JohnFrei/Pantorouter/photos/back-b.jpg

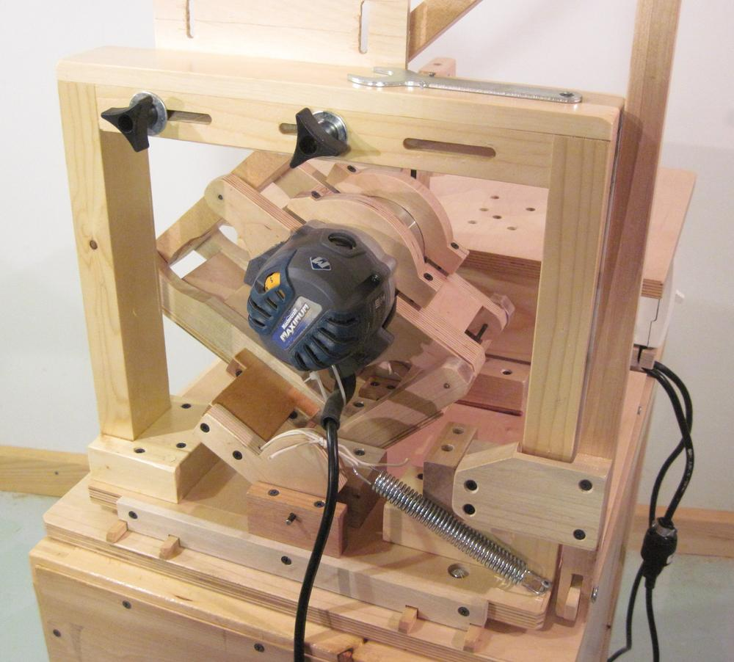
photos/back-b.jpg
