JohnFrei/Pantorouter/photos/front_left-b.jpg

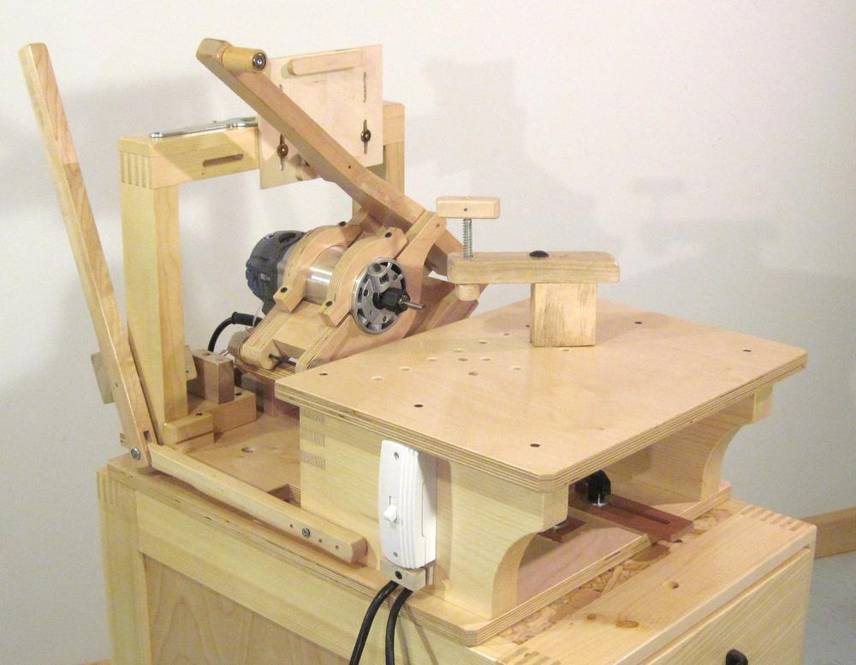
photos/front_left-b.jpg
