JohnFrei/Pantorouter/photos/front_profile-b.jpg

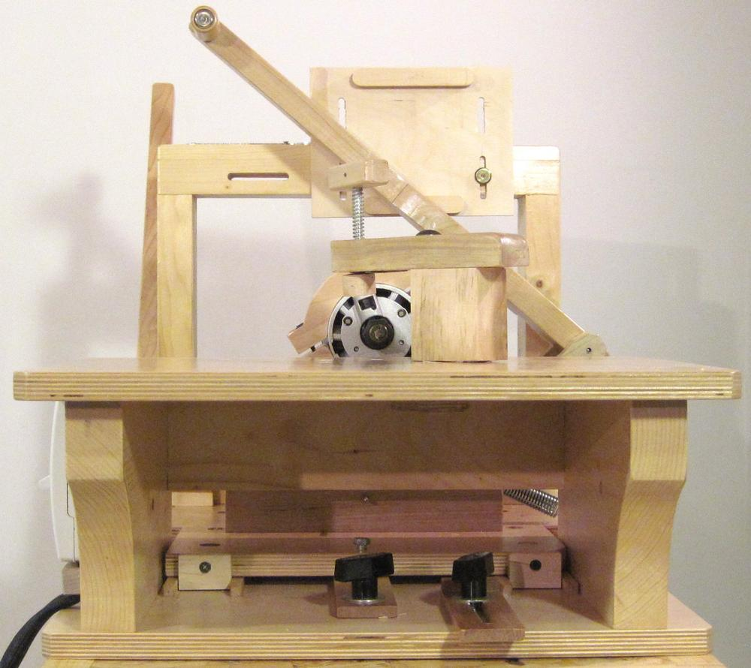
photos/front_profile-b.jpg
