JohnFrei/Pantorouter/photos/left_low-b.jpg

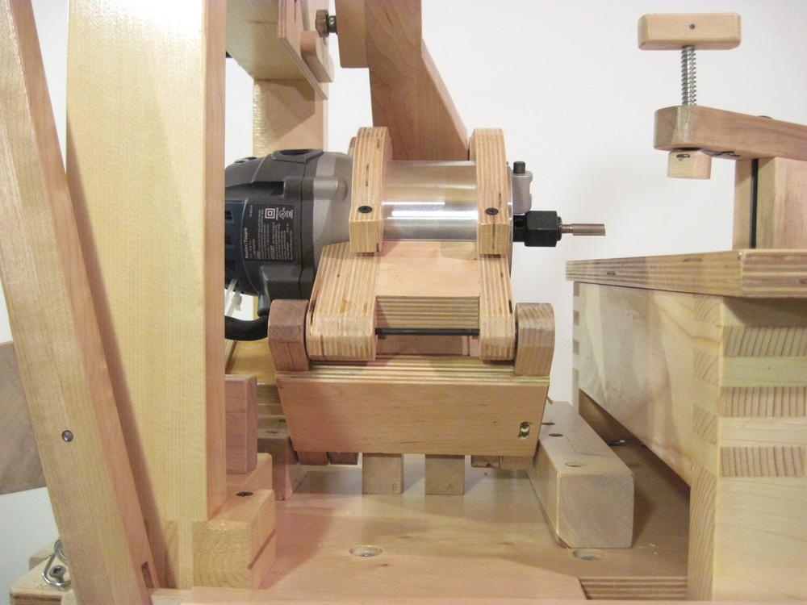
photos/left_low-b.jpg
