JohnFrei/Pantorouter/photos/left_max_height-b.jpg

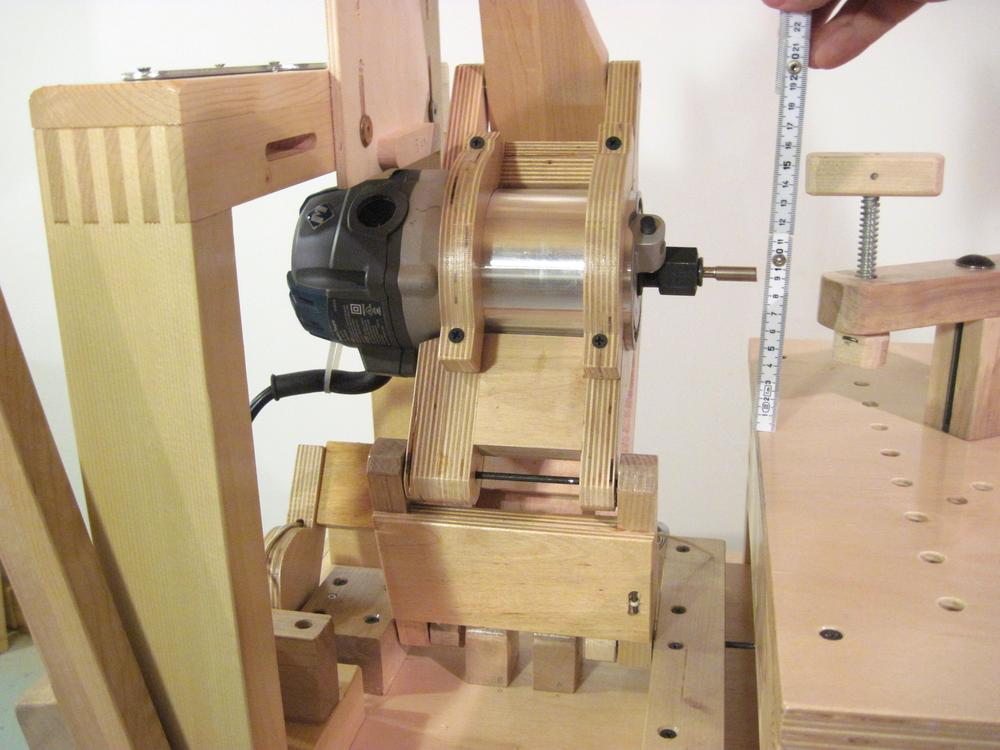
photos/left_max_height-b.jpg
