JohnFrei/Pantorouter/photos/left_side-b.jpg

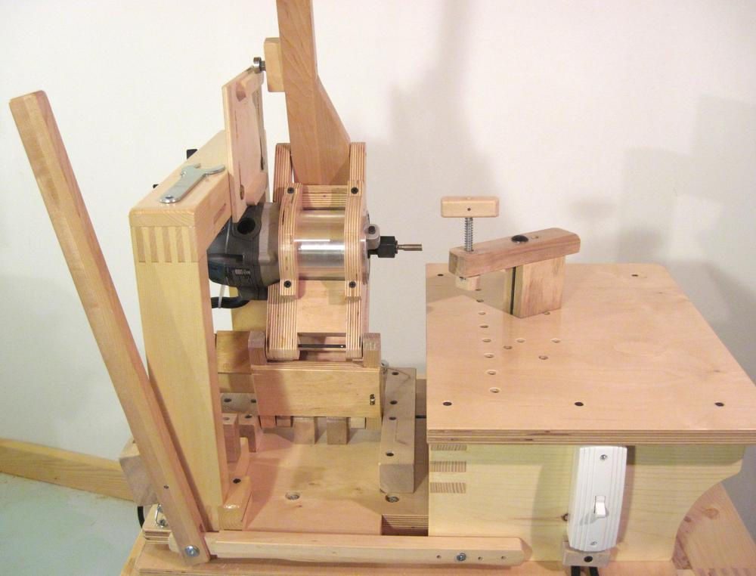
photos/left_side-b.jpg
