JohnFrei/Pantorouter/photos/right_side-b.jpg

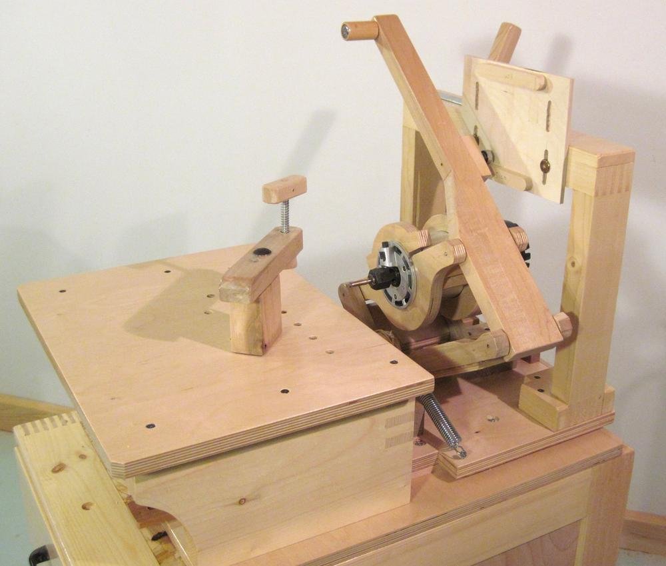
photos/right_side-b.jpg
