JohnFrei/Pantorouter/plans/11mm_ply.png

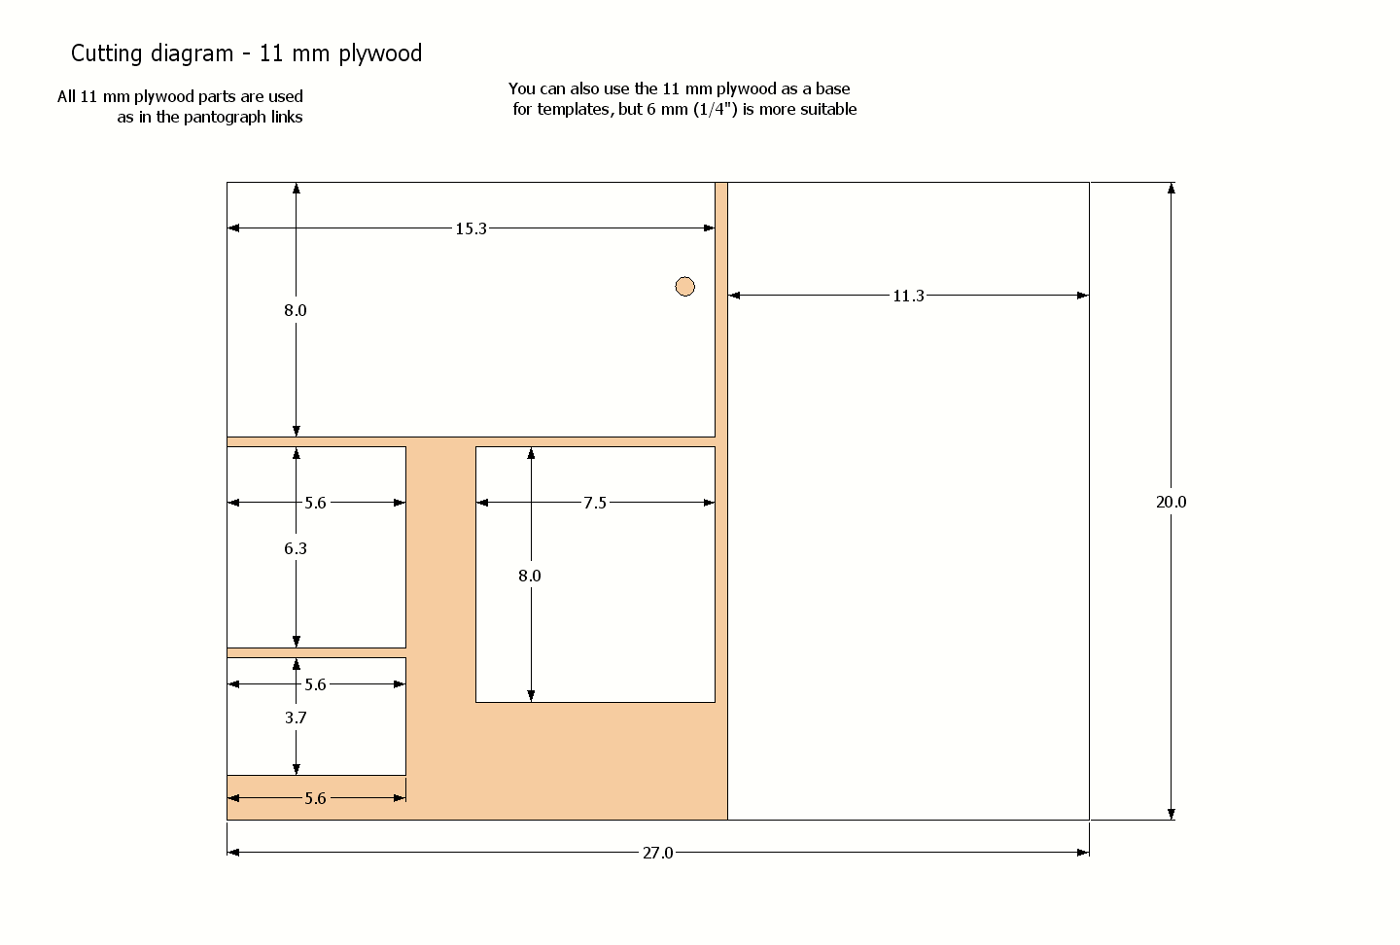
plans/11mm_ply.png
