JohnFrei/Pantorouter/plans/19mm_ply.png

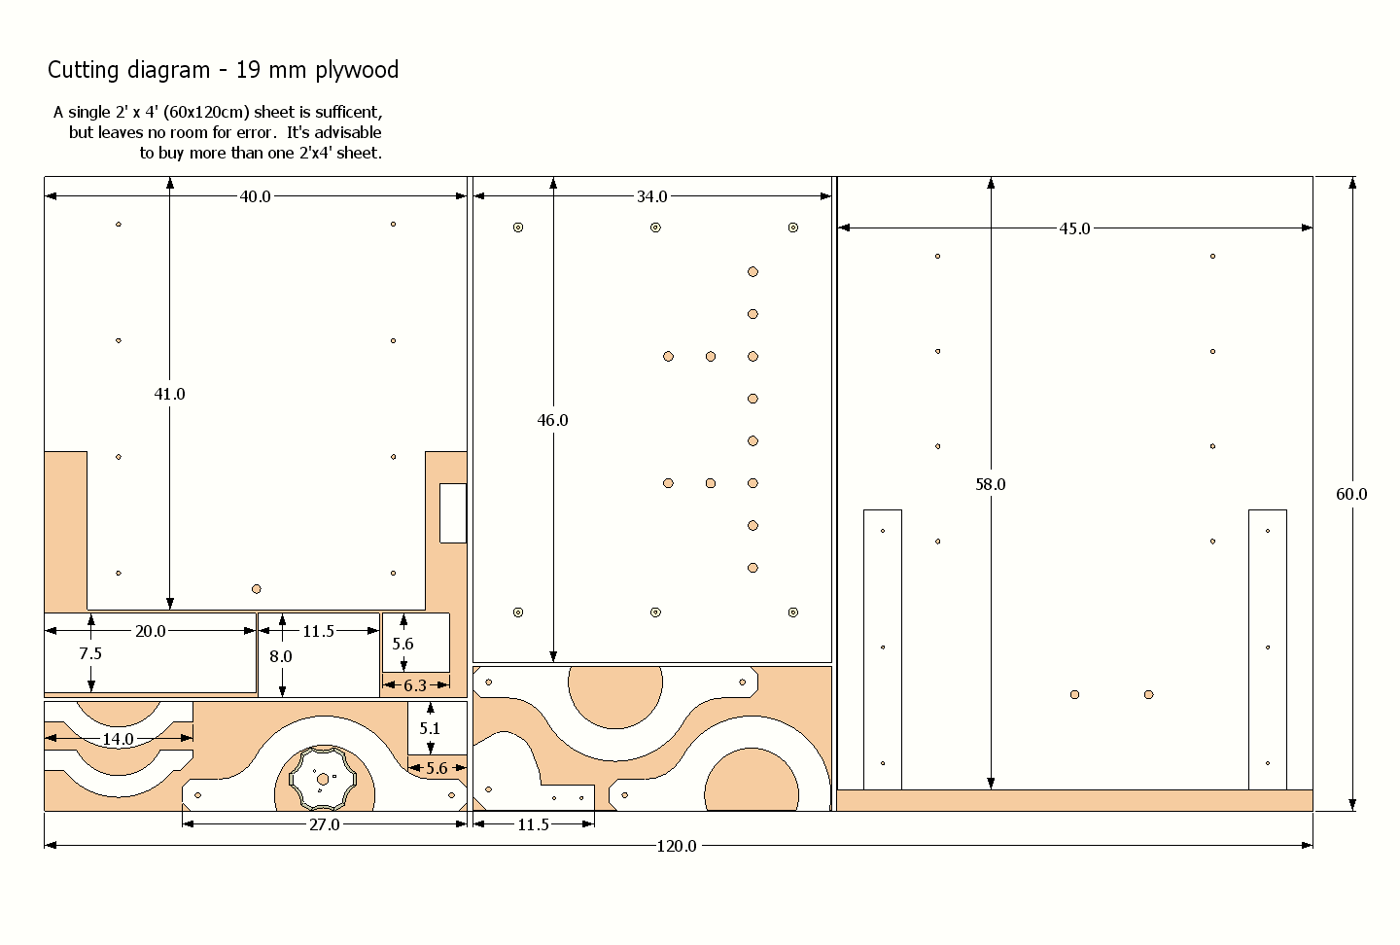
plans/19mm_ply.png
