JohnFrei/Pantorouter/plans/fence.png

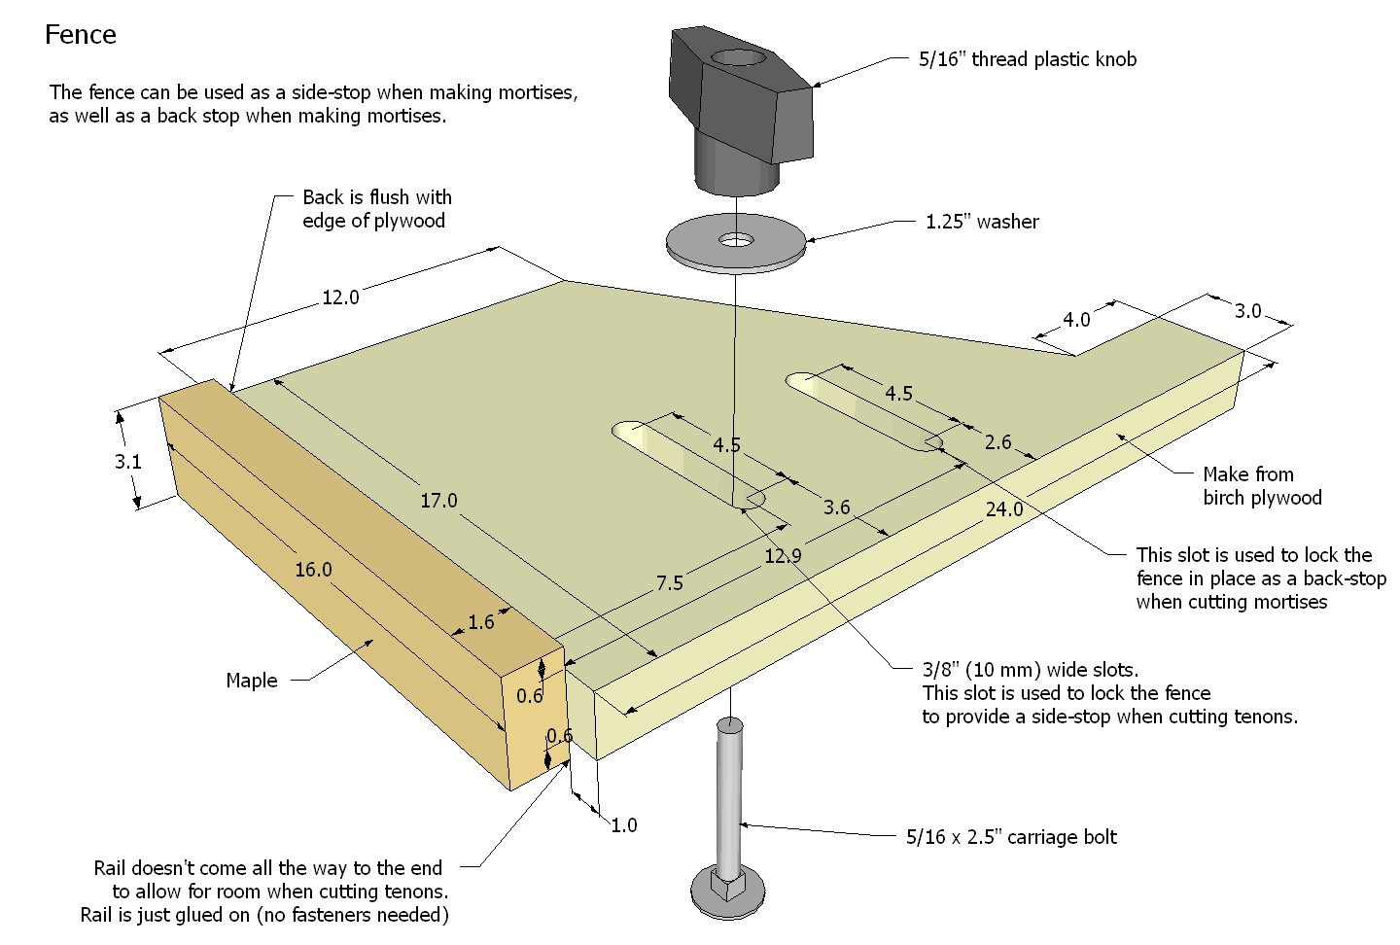
plans/fence.png
