JohnFrei/Pantorouter/plans/from_back.png

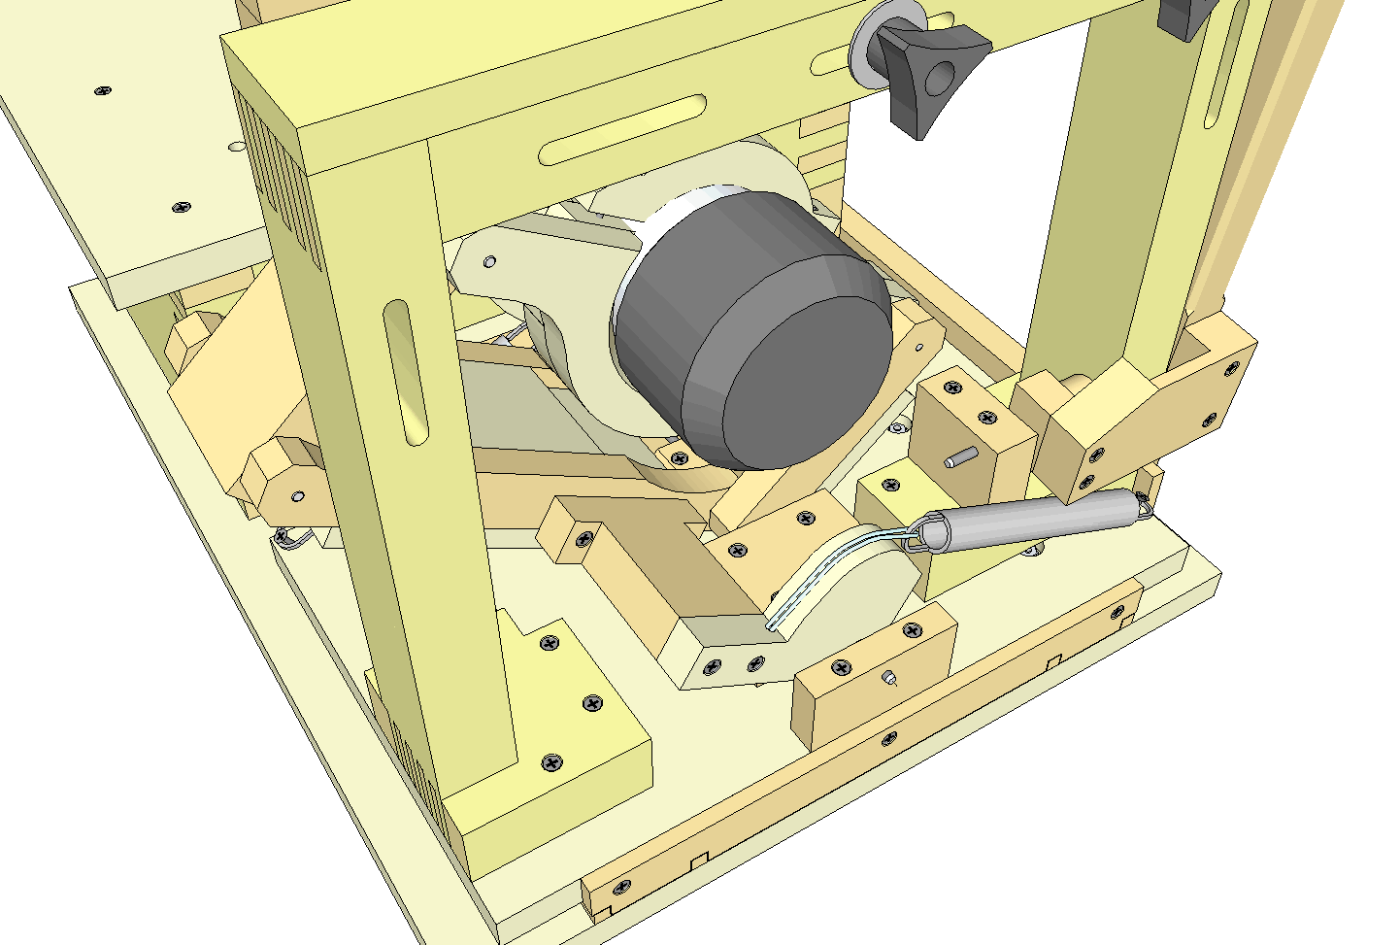
plans/from_back.png
