JohnFrei/Pantorouter/plans/main.png

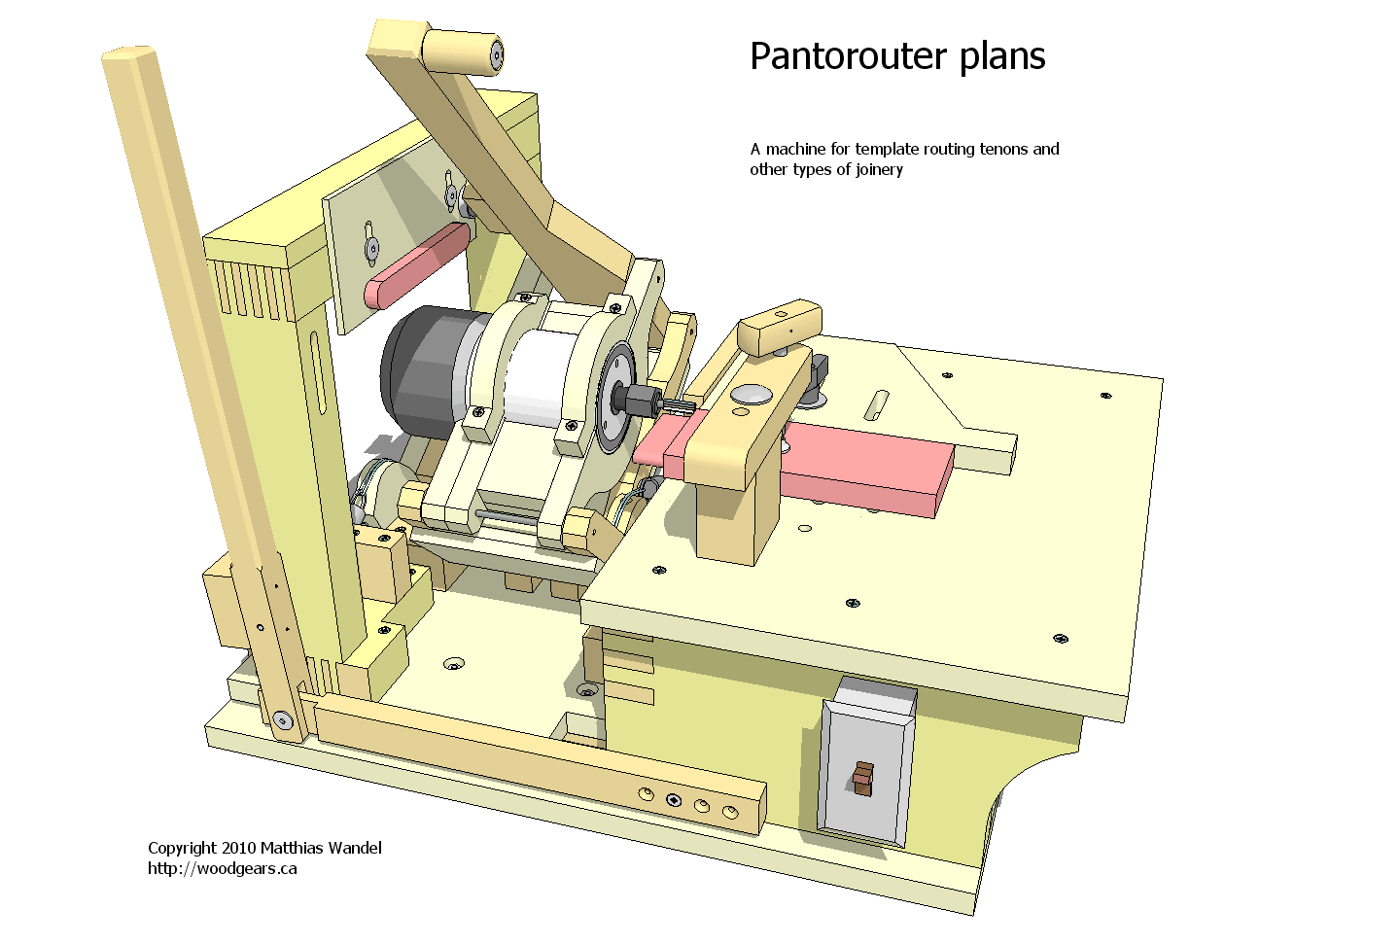
plans/main.png
