JohnFrei/Pantorouter/plans/plunge_lever.png

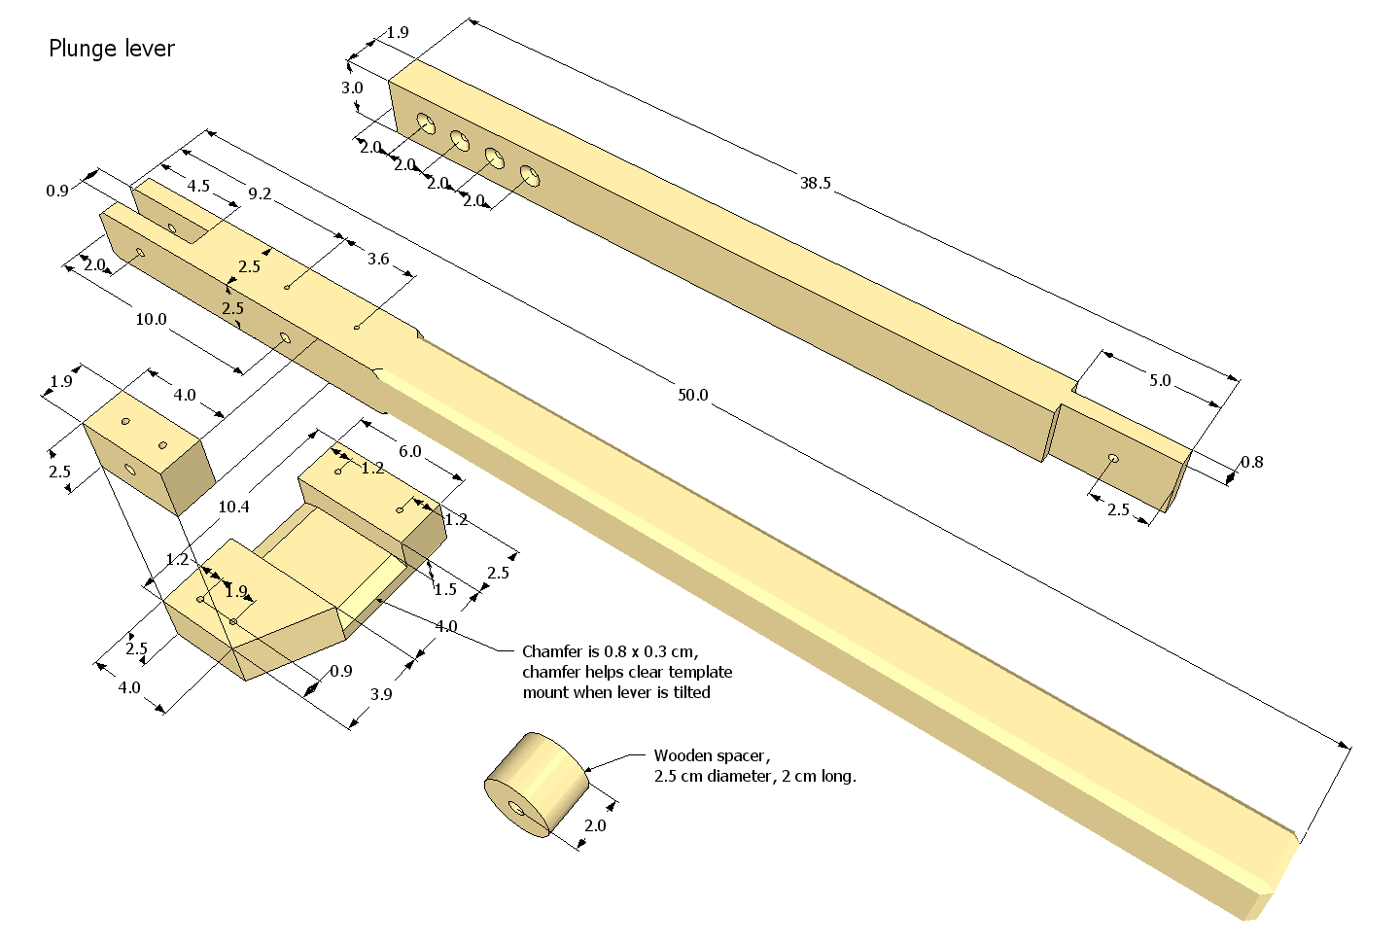
plans/plunge_lever.png
