JohnFrei/Pantorouter/plans/plunge_stops.png

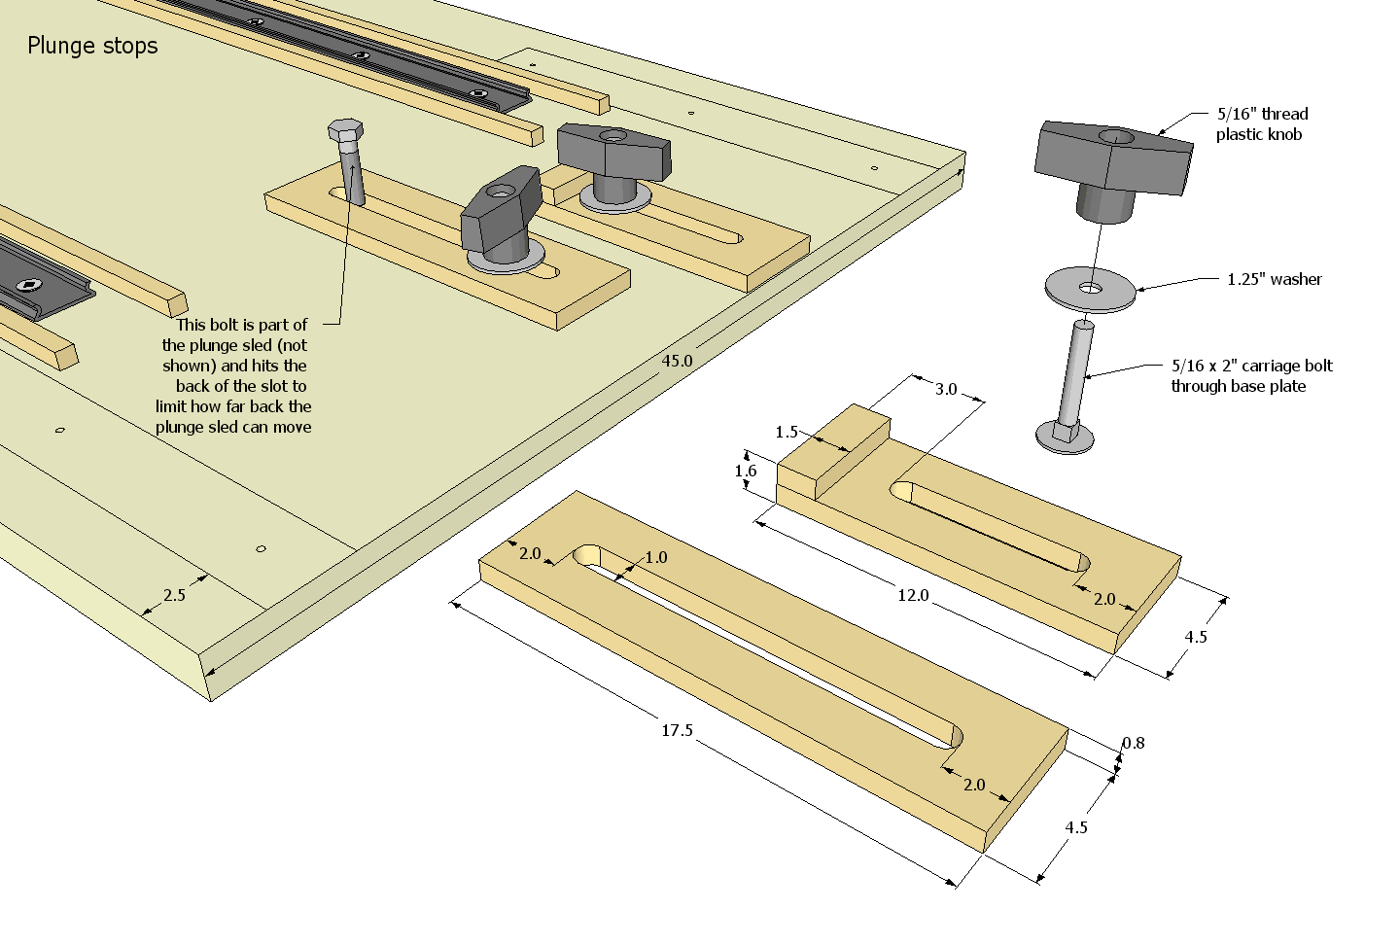
plans/plunge_stops.png
