JohnFrei/Pantorouter/plans/router_mount.png

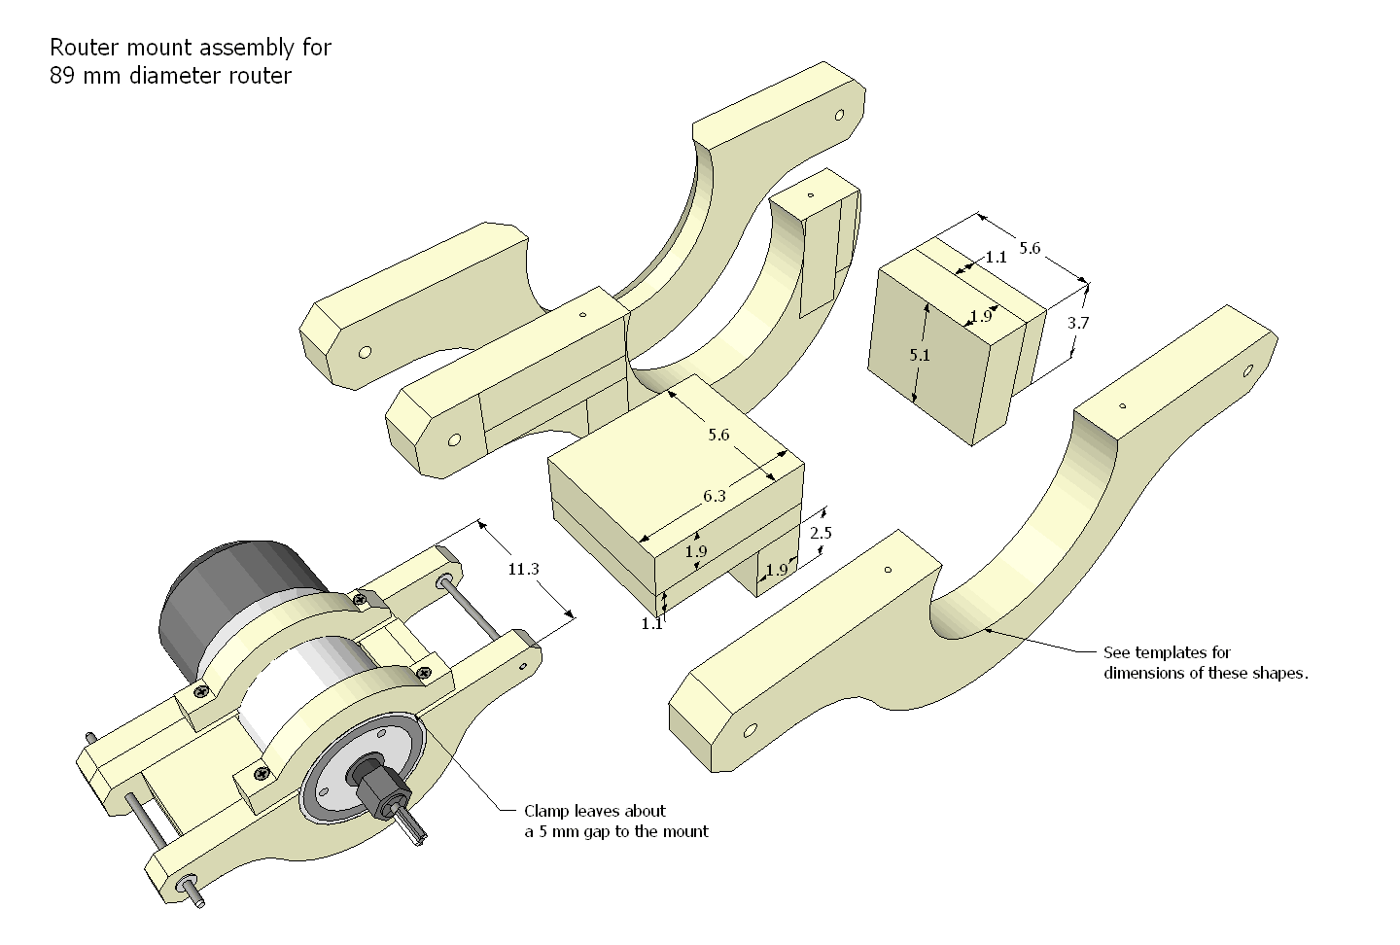
plans/router_mount.png
