JohnFrei/Pantorouter/plans/router_mount_2.png

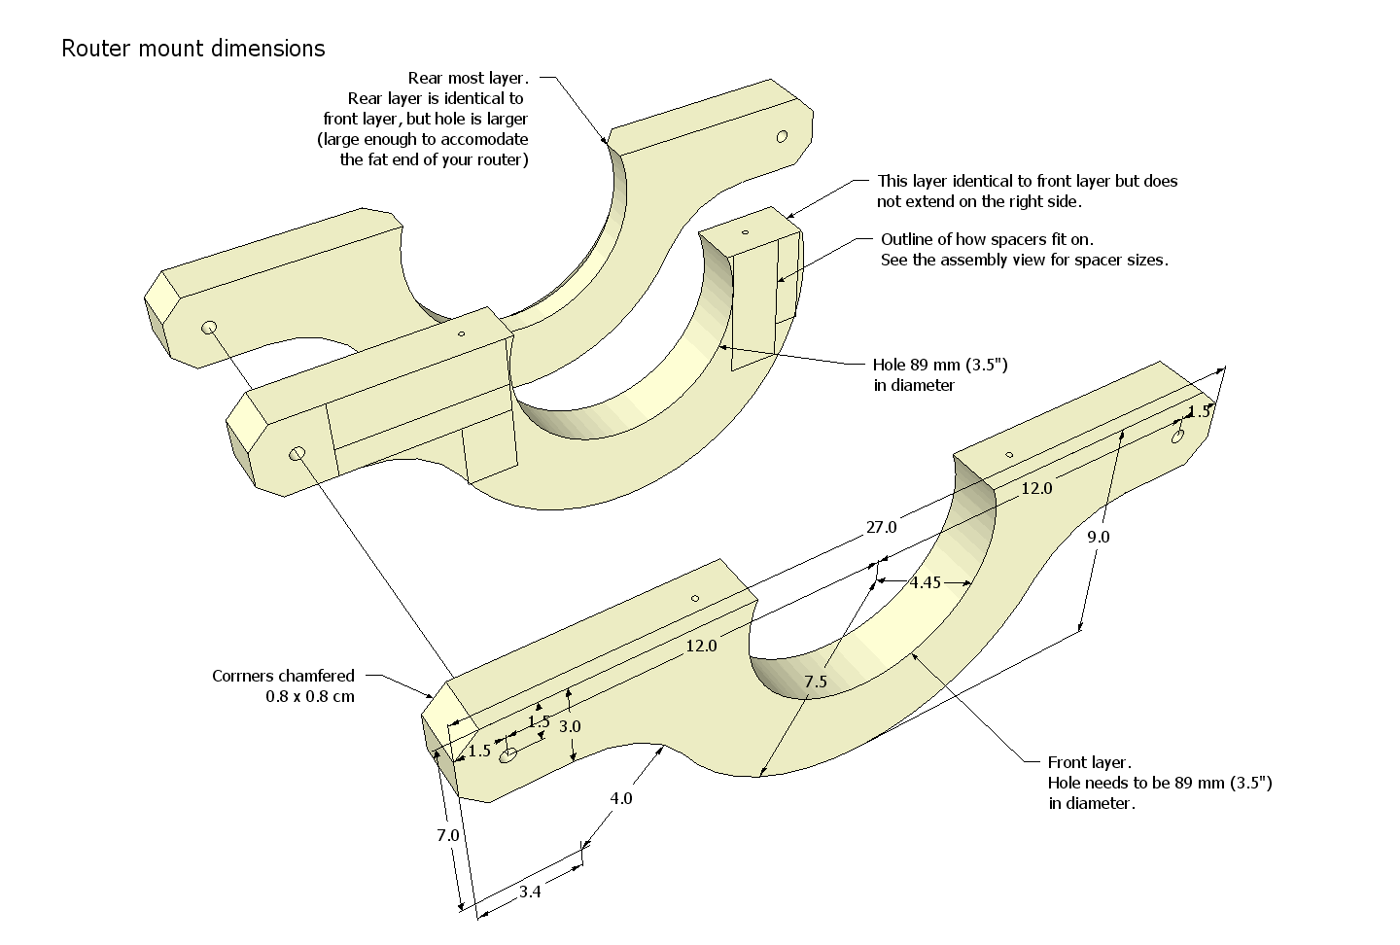
plans/router_mount_2.png
