JohnFrei/Pantorouter/plans/short_link.png

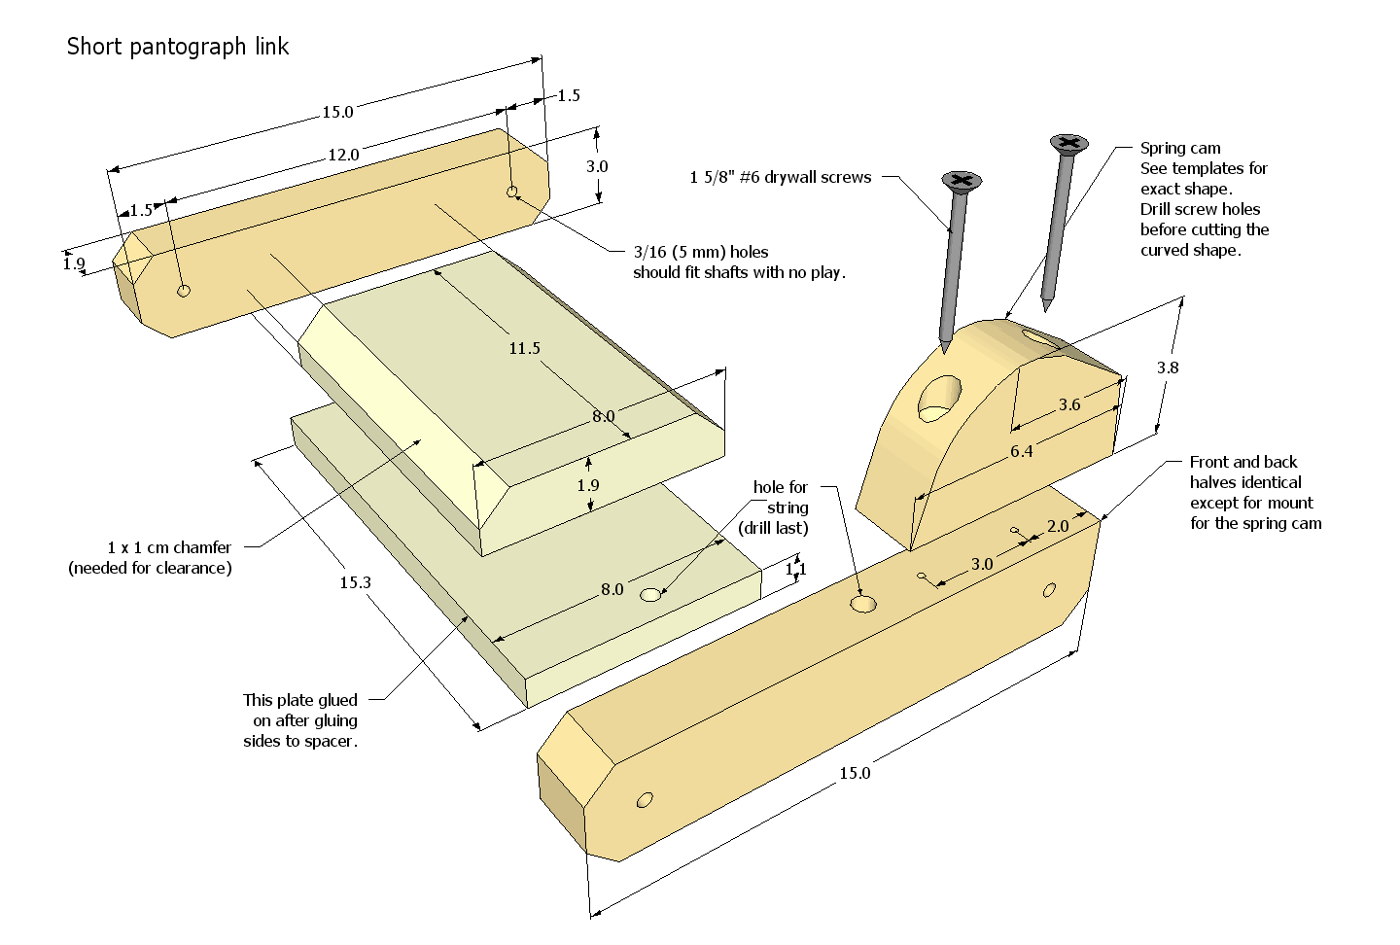
plans/short_link.png
