JohnFrei/Pantorouter/plans/sled_bot.png

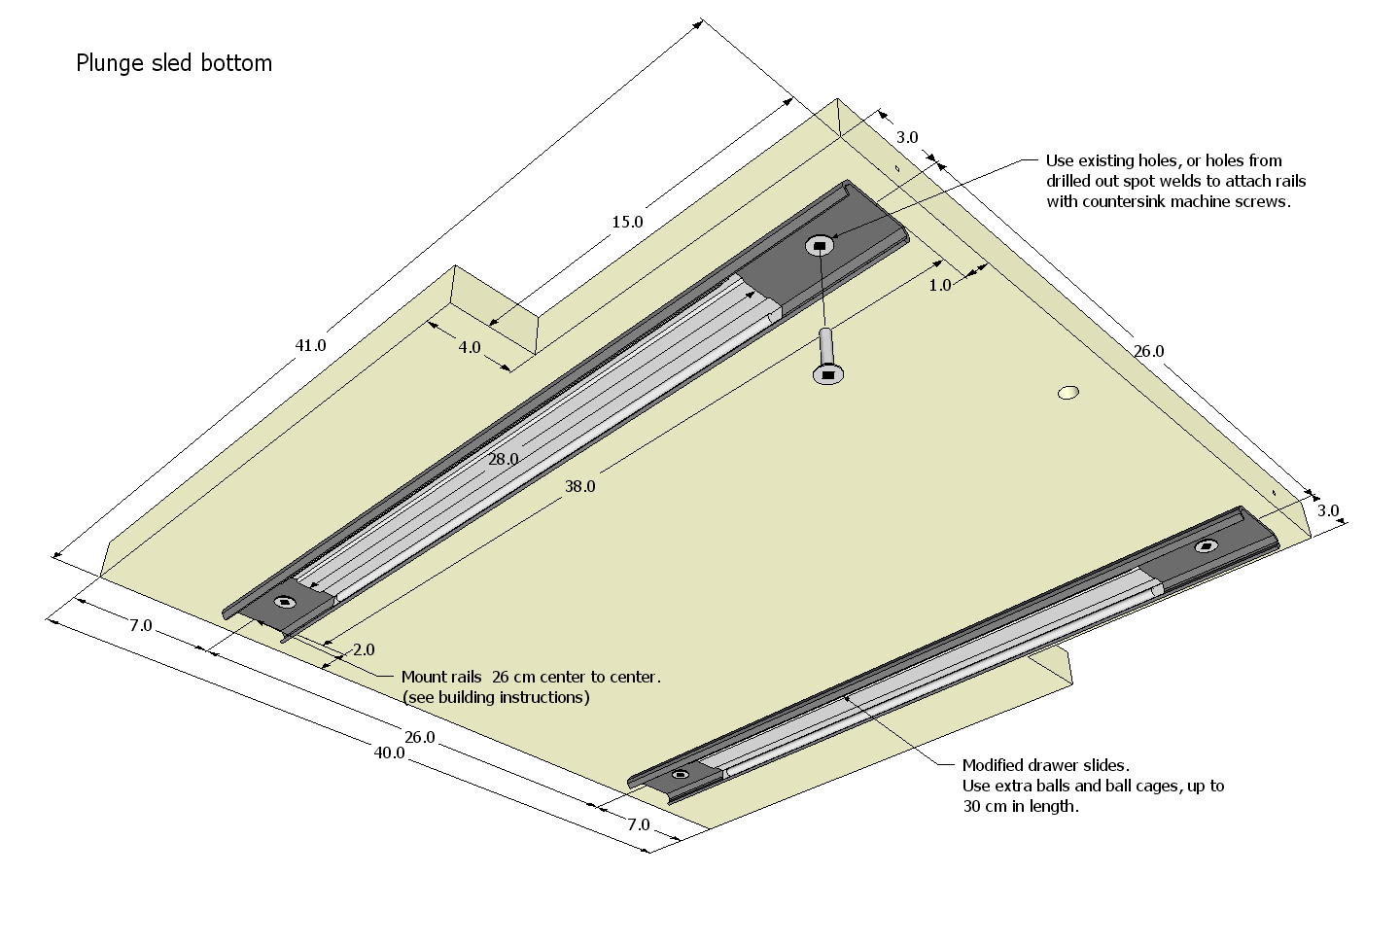
plans/sled_bot.png
