JohnFrei/Pantorouter/plans/specs.png

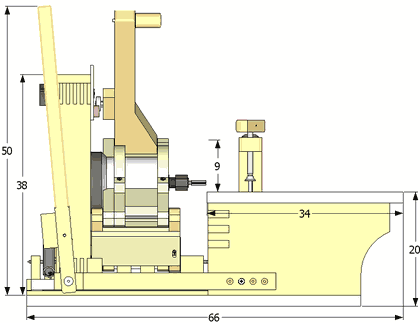
plans/specs.png
