JohnFrei/Pantorouter/plans/spruce_cut.png

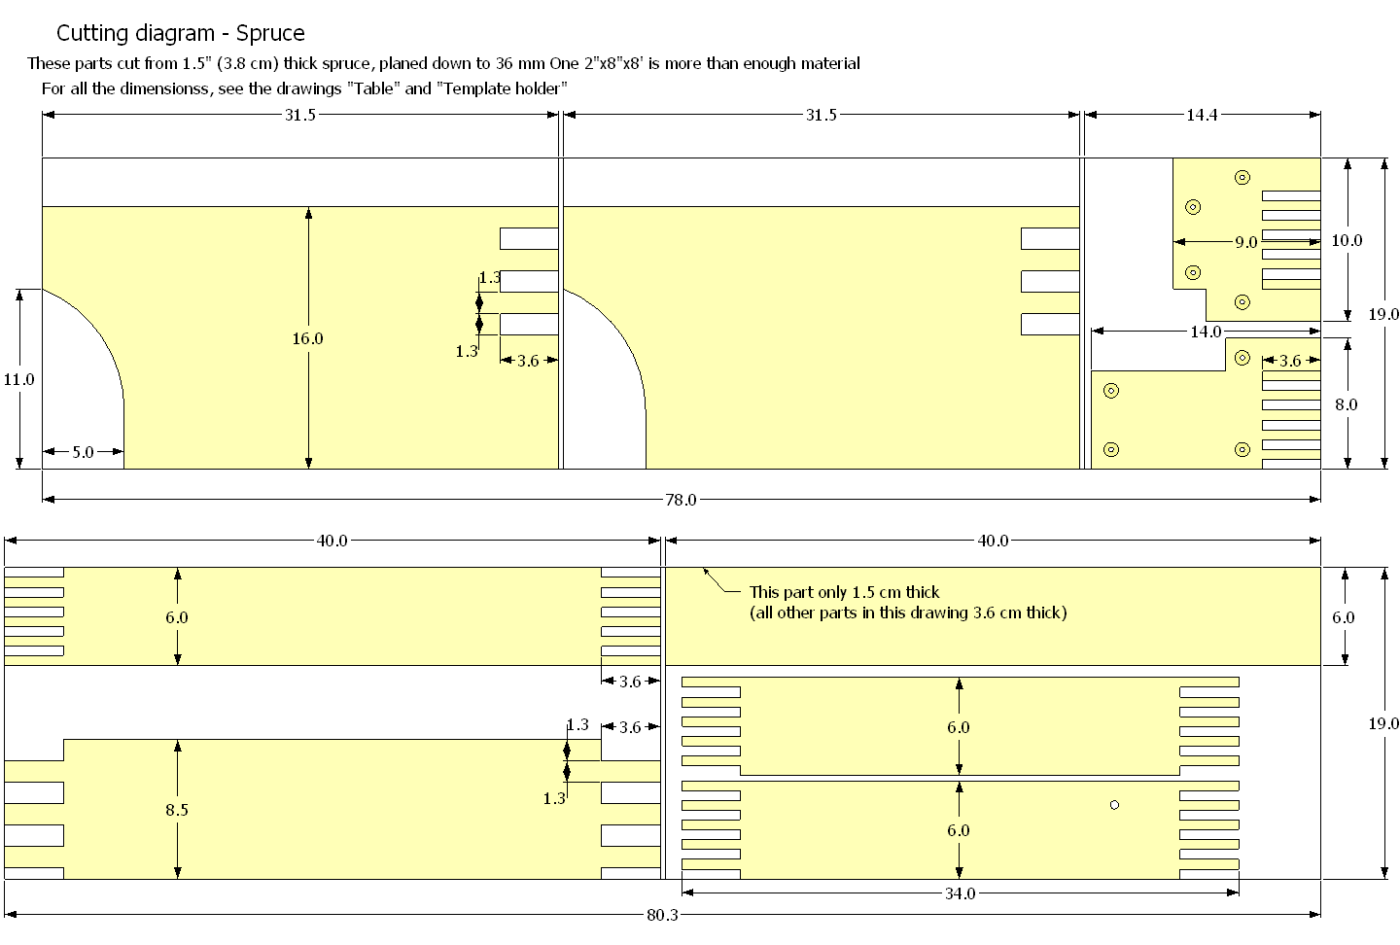
plans/spruce_cut.png
