JohnFrei/Pantorouter/plans/template_holder.png

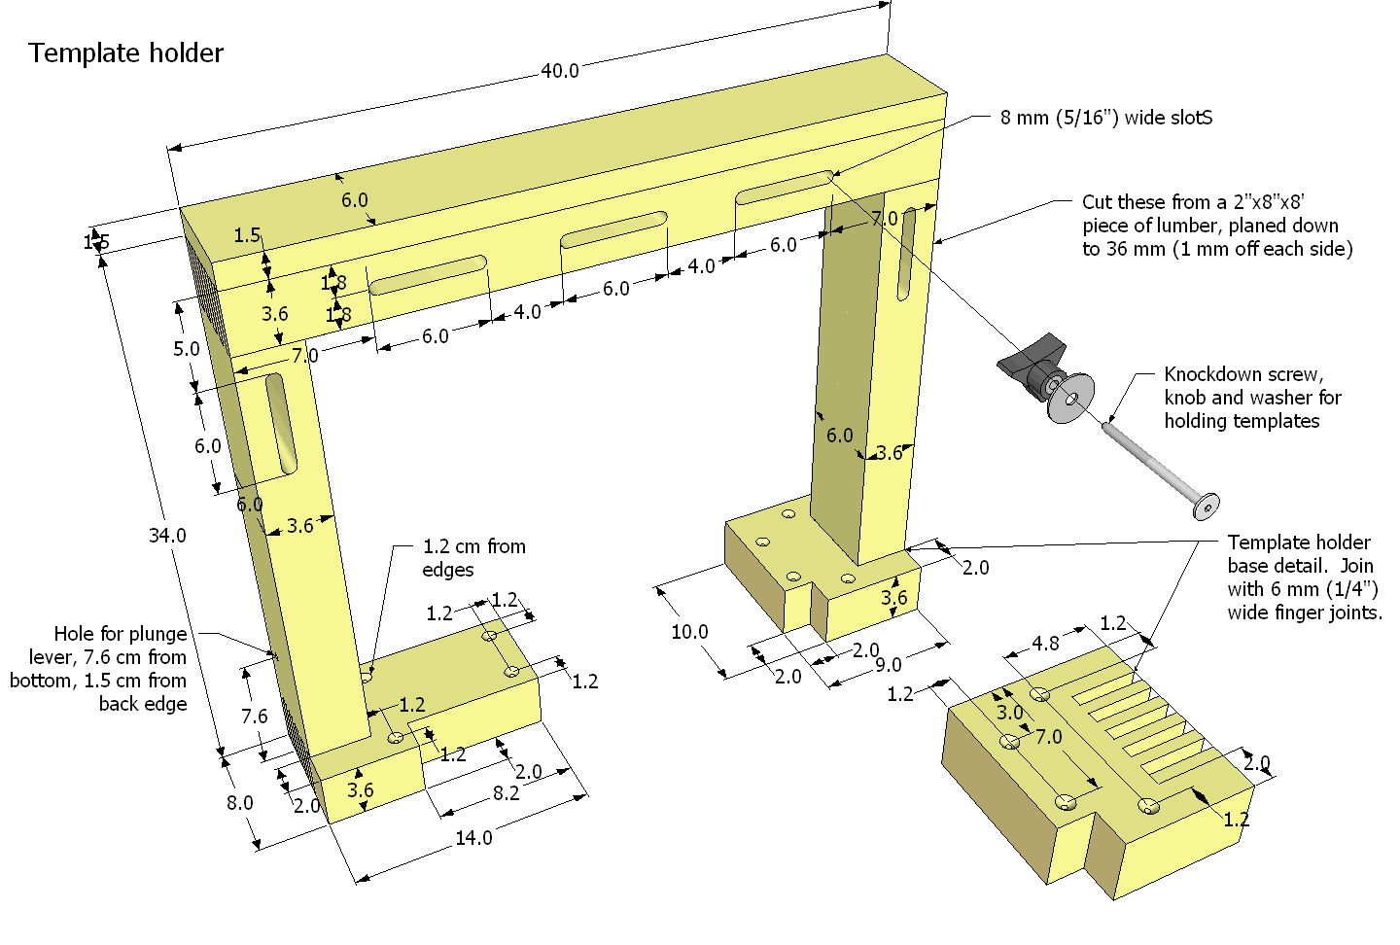
plans/template_holder.png
