JohnFrei/Pantorouter/plans/thumbnail/left_profile.png

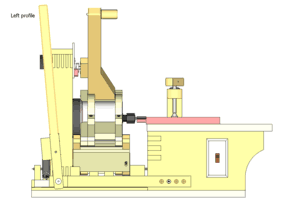
plans/thumbnail/left_profile.png
