JohnFrei/Pantorouter/plans/thumbnail/long_link.png

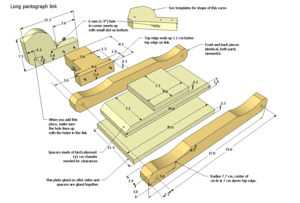
plans/thumbnail/long_link.png
