JohnFrei/Pantorouter/plans/thumbnail/plunge_detail.png

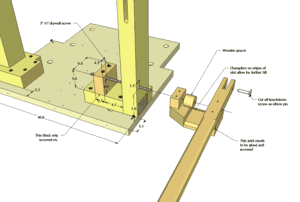
plans/thumbnail/plunge_detail.png
