JohnFrei/Pantorouter/plans/thumbnail/sled.png

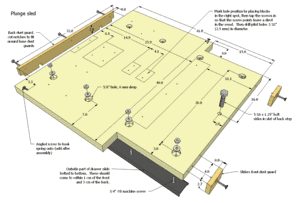
plans/thumbnail/sled.png
