JohnFrei/Pantorouter/plans/thumbnail/specs.png

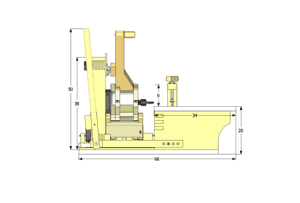
plans/thumbnail/specs.png
