JohnFrei/Pantorouter/plans/thumbnail/table.png

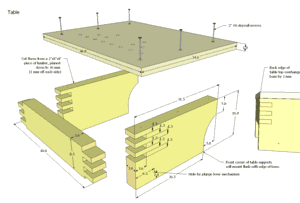
plans/thumbnail/table.png
