JohnFrei/Pantorouter/templates/back_1-1.png

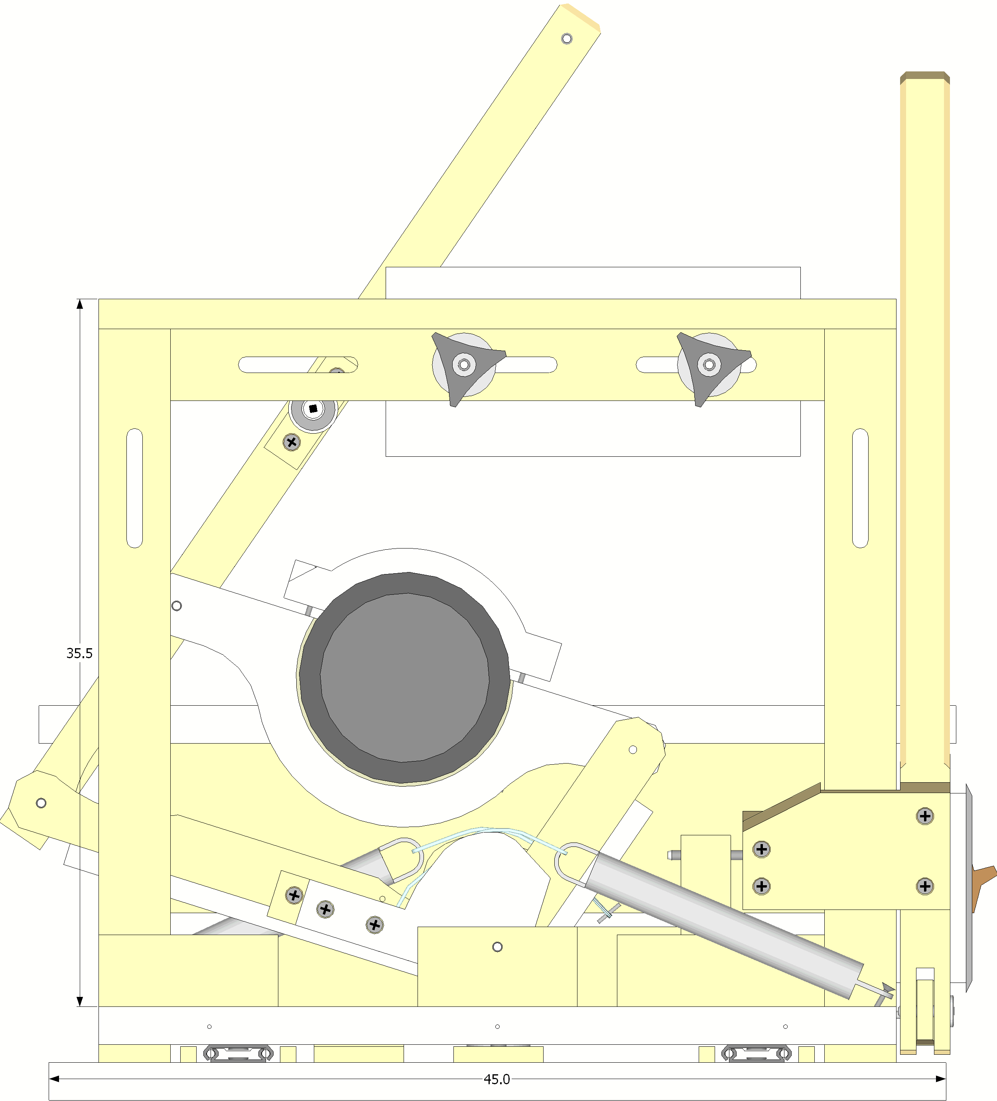
templates/back_1-1.png
