JohnFrei/Pantorouter/templates/left_1-1.png

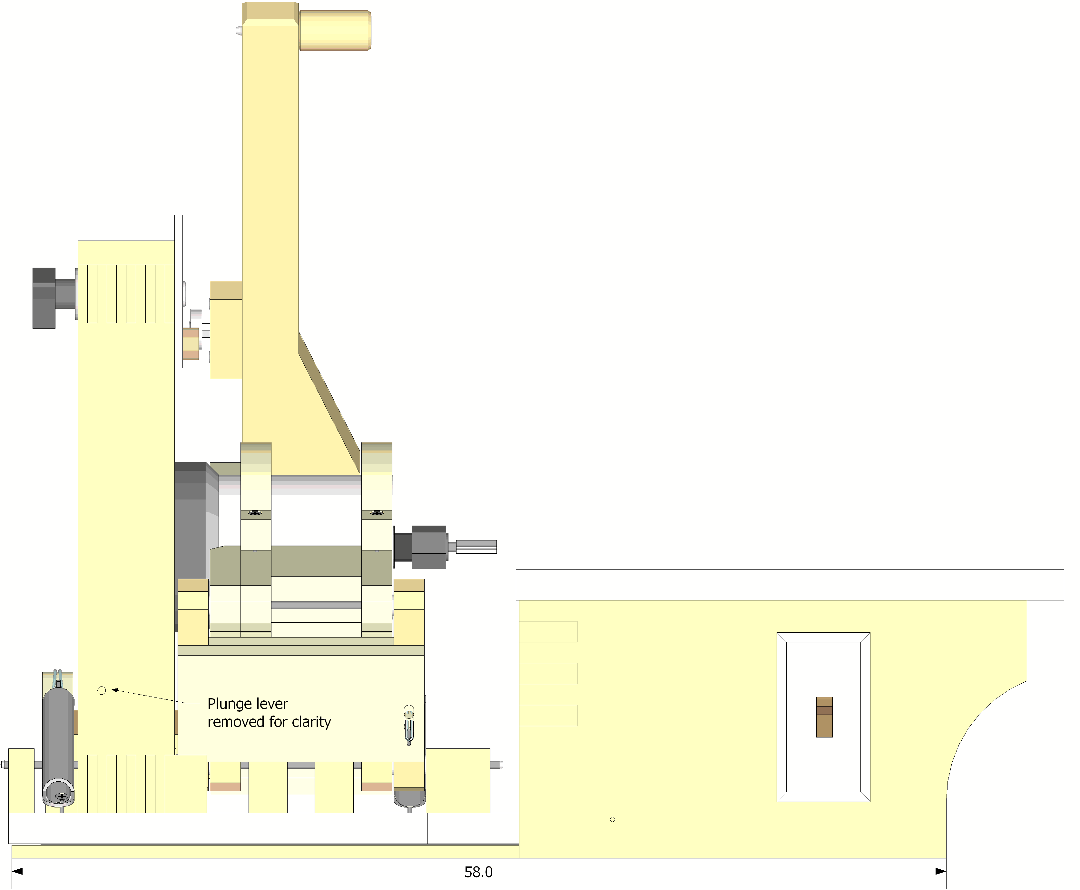
templates/left_1-1.png
