JohnFrei/Pantorouter/templates/links.png

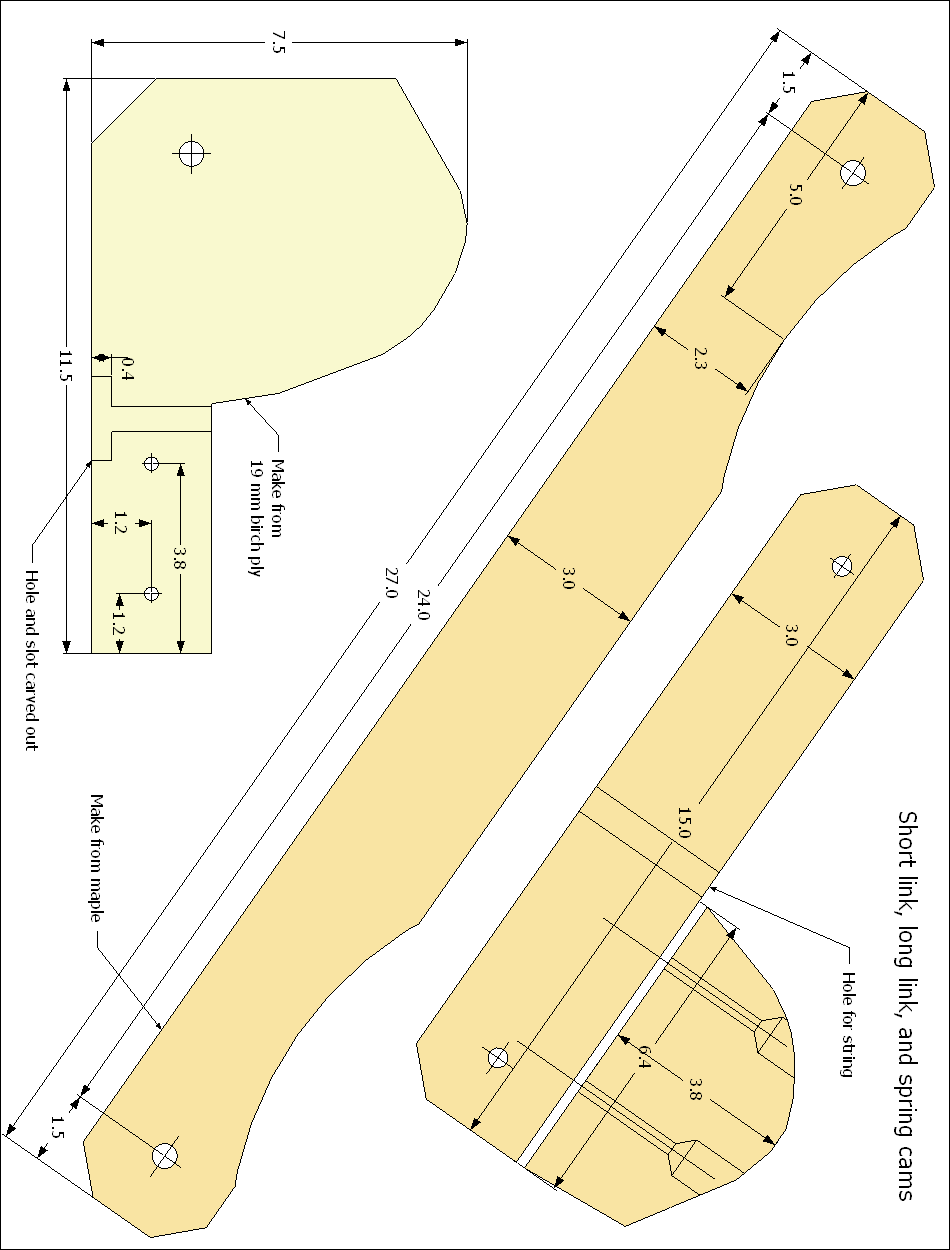
templates/links.png
