JohnFrei/Pantorouter/templates/m8t2.png

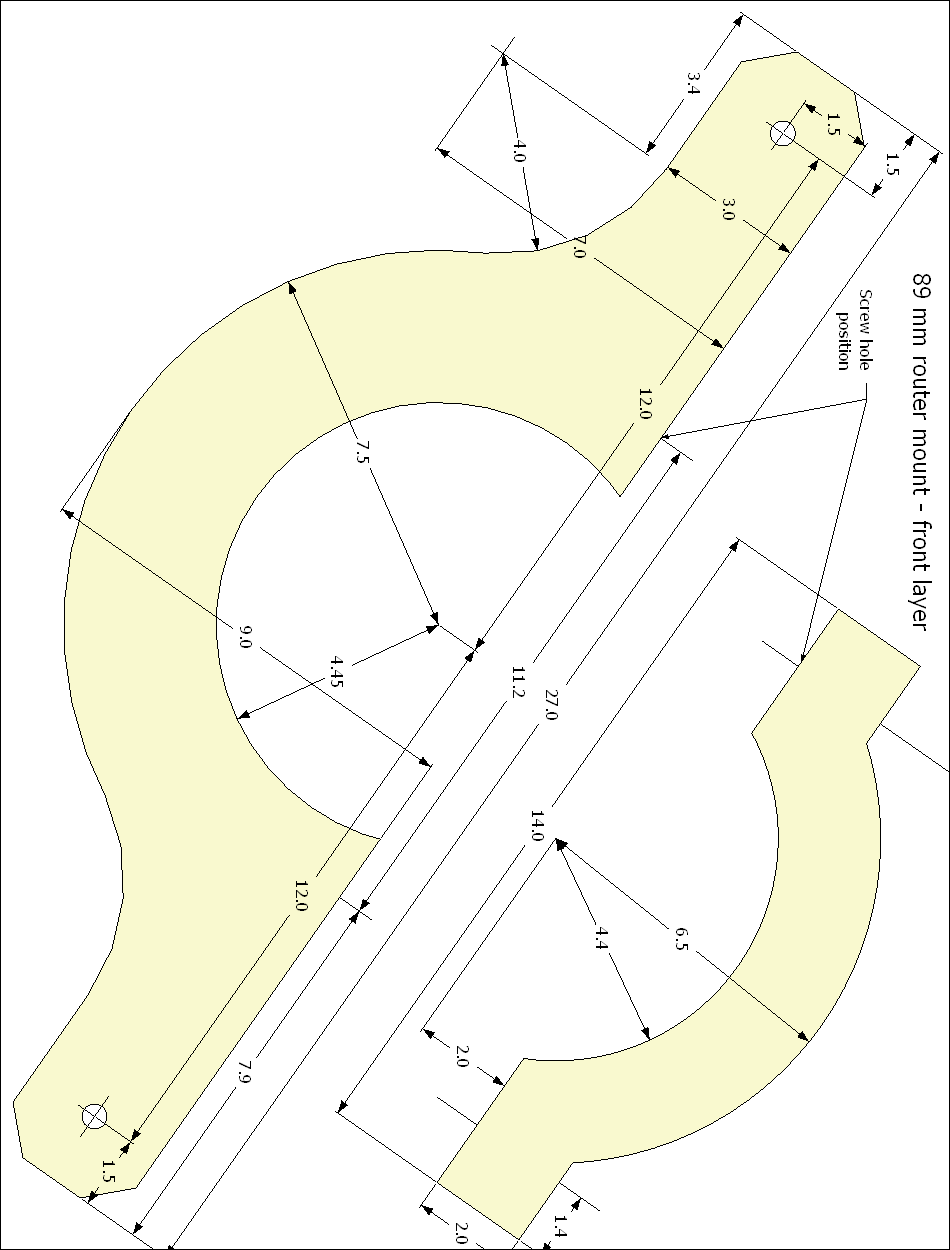
templates/m8t2.png
