JohnFrei/Pantorouter/templates/thumbnail/links.png

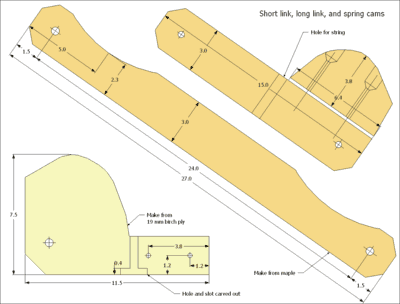
templates/thumbnail/links.png
