JohnFrei/Pantorouter/templates/thumbnail/m7t1.png

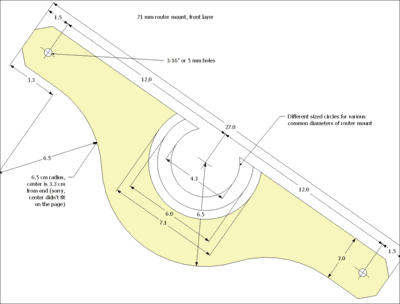
templates/thumbnail/m7t1.png
