JohnFrei/Pantorouter/templates/thumbnail/m7t2.png

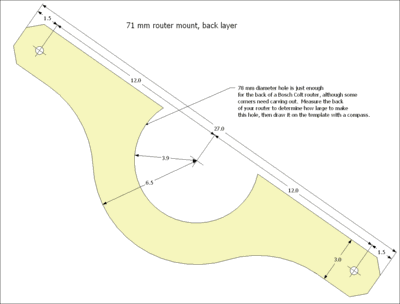
templates/thumbnail/m7t2.png
