JohnFrei/Pantorouter/templates/thumbnail/m7t3.png

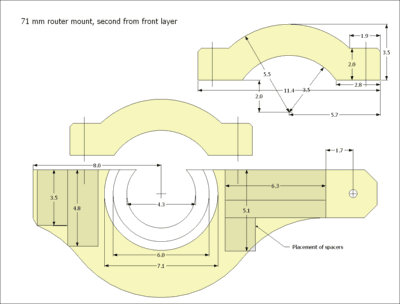
templates/thumbnail/m7t3.png
