JohnFrei/Pantorouter/templates/thumbnail/m8t2.png

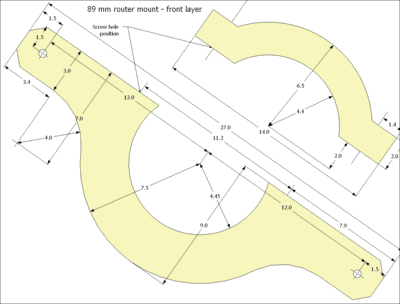
templates/thumbnail/m8t2.png
