JohnFrei/Pantorouter/templates/thumbnail/m8t3.png

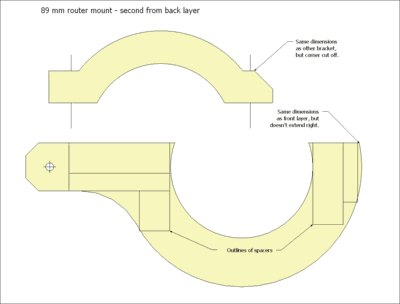
templates/thumbnail/m8t3.png
