JohnFrei/Pantorouter/templates/thumbnail/tmpl1.png

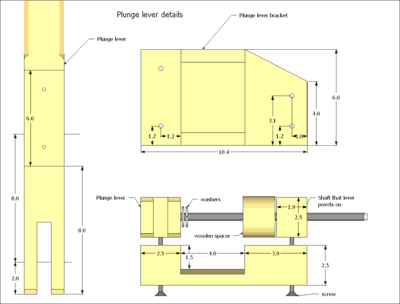
templates/thumbnail/tmpl1.png
