JohnFrei/Pantorouter/templates/thumbnail/tmpl2.png

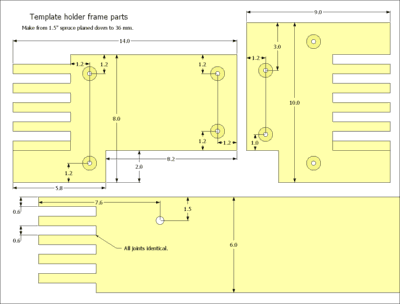
templates/thumbnail/tmpl2.png
