JohnFrei/Pantorouter/templates/thumbnail/tmpl3.png

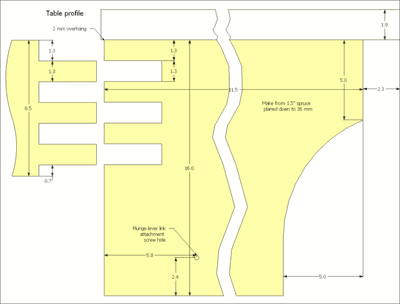
templates/thumbnail/tmpl3.png
