JohnFrei/Pantorouter/templates/thumbnail/tmpl4.png

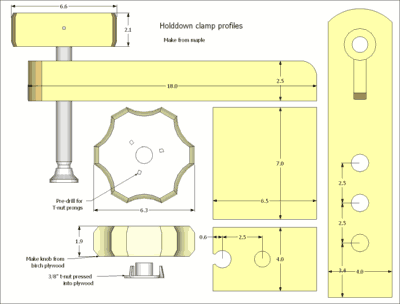
templates/thumbnail/tmpl4.png
