JohnFrei/Pantorouter/templates/thumbnail/tmpl5.png

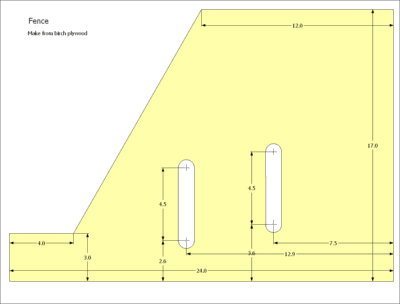
templates/thumbnail/tmpl5.png
