JohnFrei/Pantorouter/templates/thumbnail/top_1-1.png

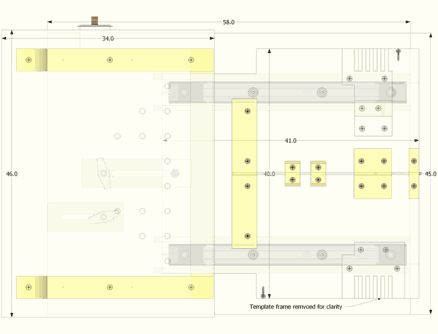
templates/thumbnail/top_1-1.png
