JohnFrei/Pantorouter/templates/tmpl3.png

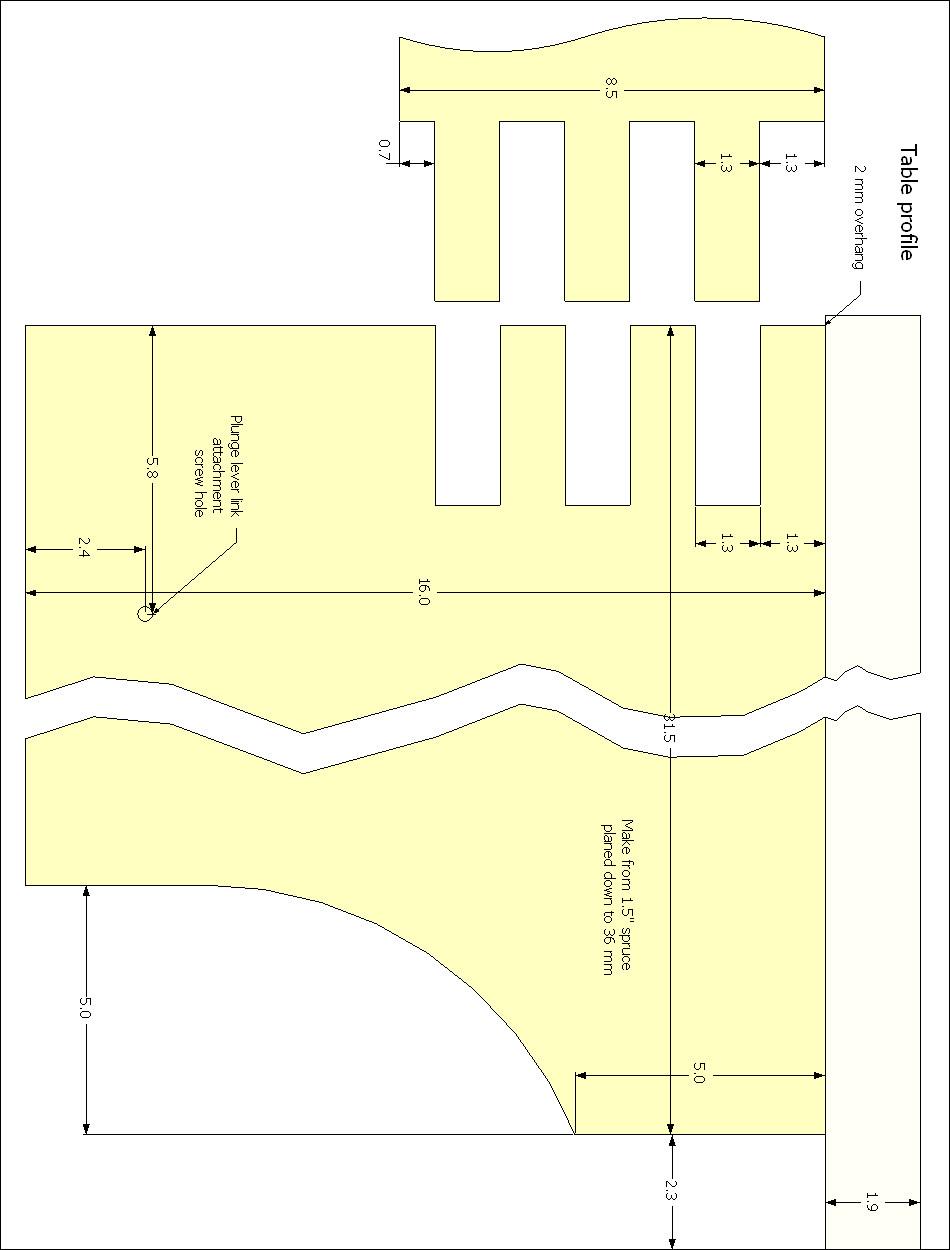
templates/tmpl3.png
