JohnFrei/Pantorouter/templates/tmpl4.png

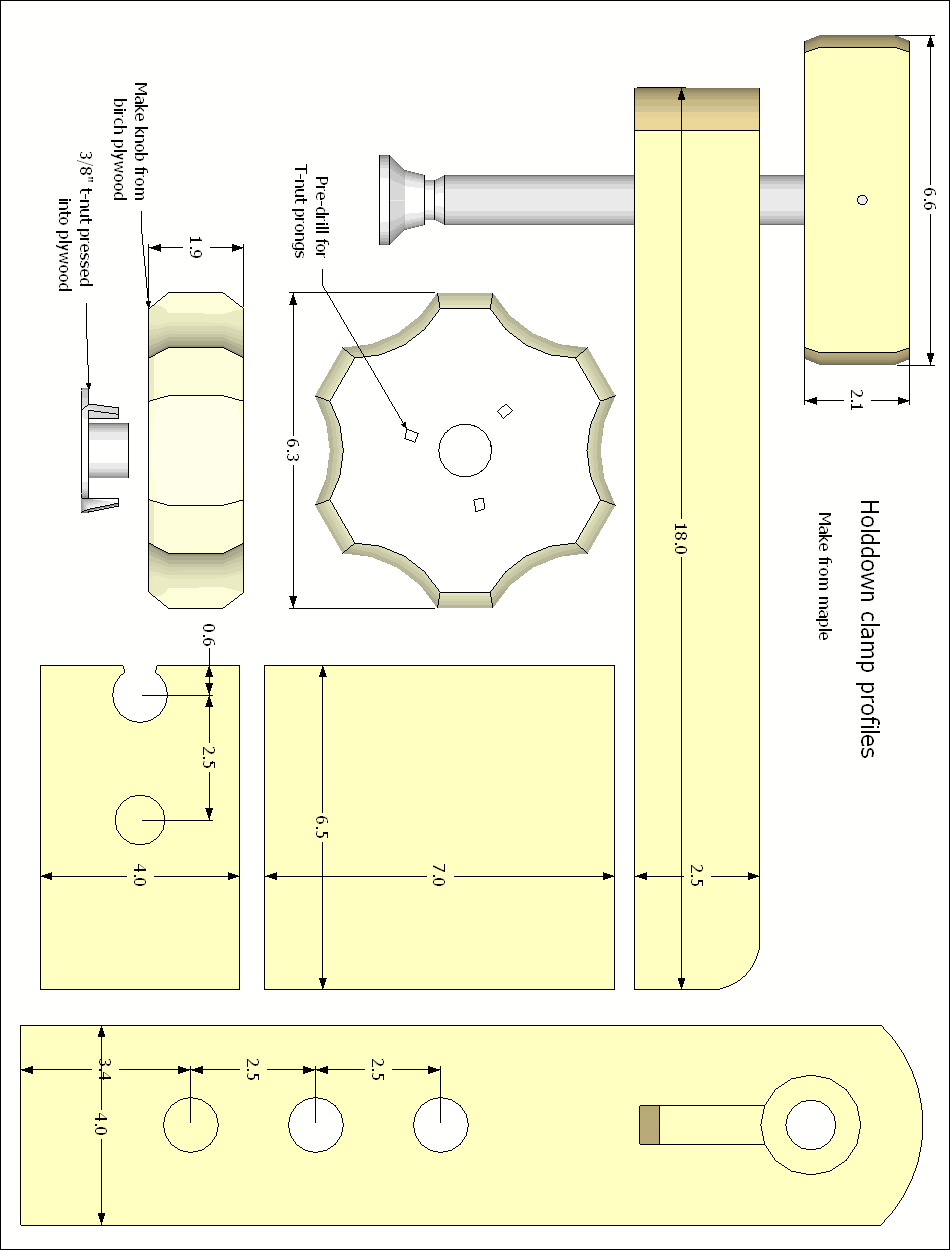
templates/tmpl4.png
