JohnFrei/Pantorouter/templates/tmpl5.png

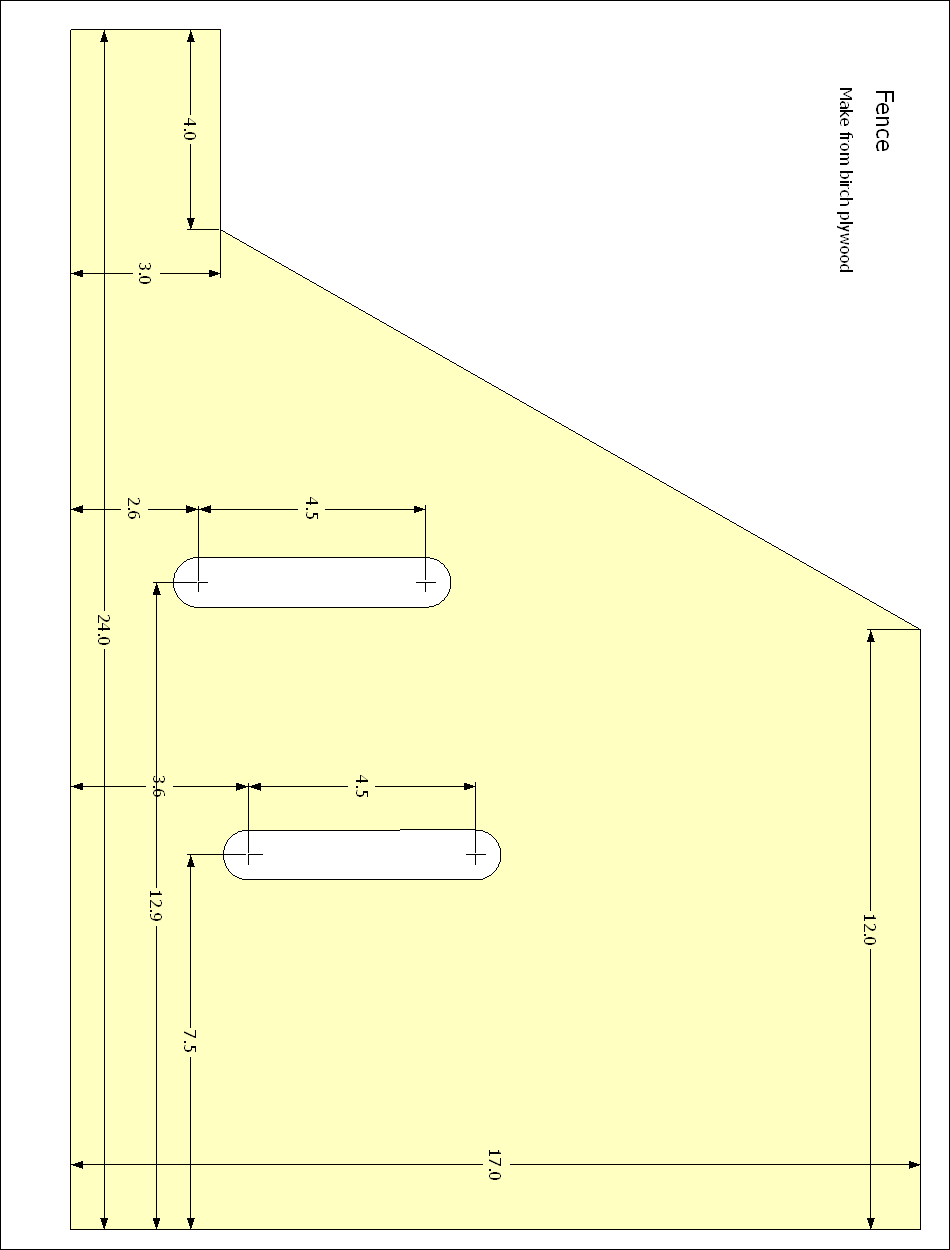
templates/tmpl5.png
