JohnFrei/Pantorouter/templates/top_1-1.png

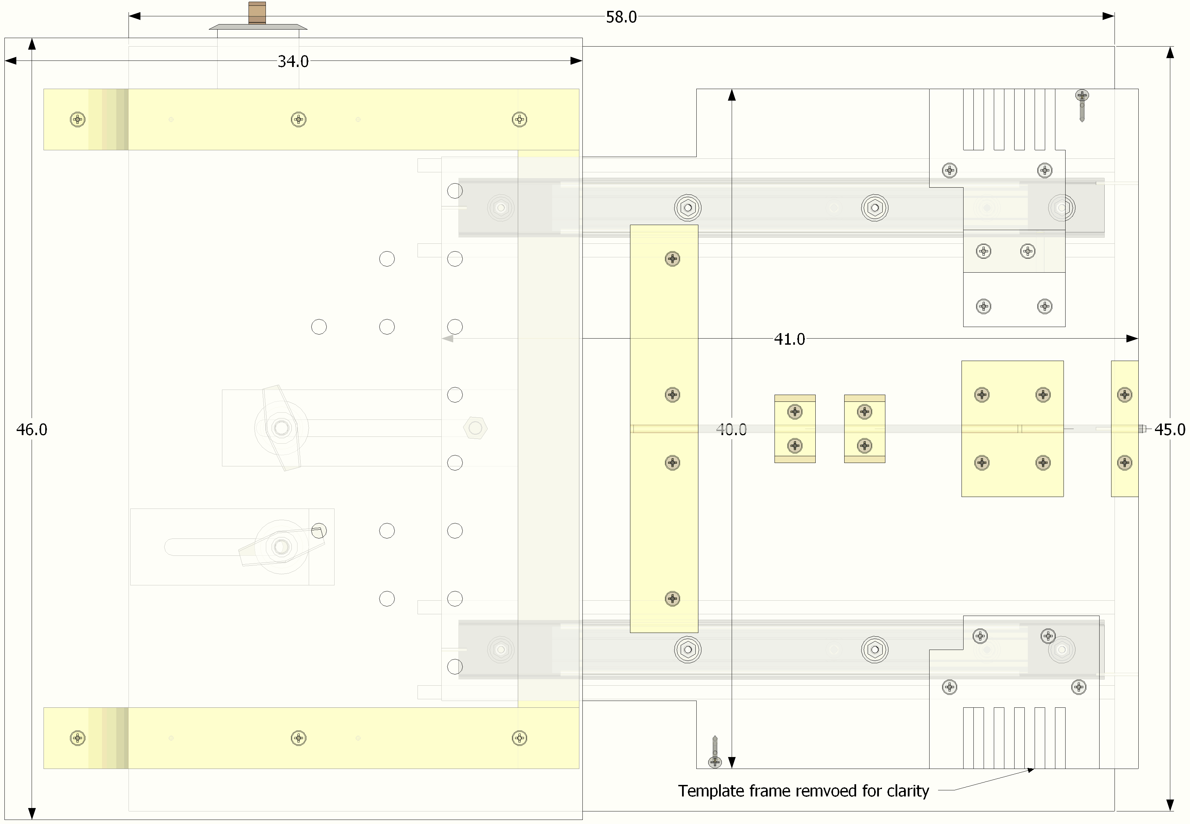
templates/top_1-1.png
