JohnFrei/Pantorouter/parts/drywall_screws.jpg

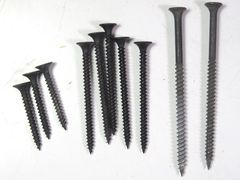
parts/drywall_screws.jpg
