JohnFrei/Pantorouter/parts/nr_8_machine_screws.jpg

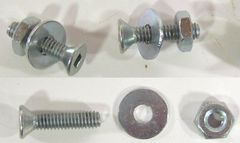
parts/nr_8_machine_screws.jpg
