JohnFrei/Pantorouter/parts/washers.jpg

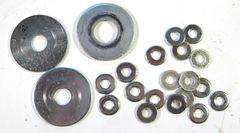
parts/washers.jpg
