JohnFrei/Pantorouter/(list of files, cad)

Other CAD files:
pantorouter.skp
