JohnFrei/Pantorouter/build/templates.html

# How to make templates for the pantorouter

A frequently asked question about the pantorouter is where to get tenon templates for it.

However, I do not know what size tenons you would like to make, which size router bit you want to use, and what size your follower bearing are. In addition, it actually makes very little sense to use paper templates when making tenon templates on the pantorouter. However, if your follower bearing is exactly twice the diameter of your router bit, then the template needs to be exactly twice the size of your tenon. (See how it works (http://woodgears.ca/pantorouter/how_it_works.html))

I have covered this topic in detail on my website in this article:
Making tenon templates for the pantorouter (http://woodgears.ca/pantorouter/tenon_setup.html)

Additional resources about making tenon templates:
Dave Tenney on making pantorouter templates (http://woodgears.ca/pantorouter/tenney.html)
Making large mortise and tenon joints with the pantorouter (http://woodgears.ca/pantorouter/large_mortise.html)

Also, I have an article on making through dovetail templates (http://woodgears.ca/pantorouter/dovetail.html)
and this article (http://woodgears.ca/pantorouter/kuldeep/dovetail.html) may also be a useful relating to dovetail joints.

The pantorouter can be used many different types of joints.
Please see my many articles about using the pantorouter (http://woodgears.ca/pantorouter/index.html) on my website.
