JohnFrei/Pantorouter/build/using/fence.html

A fence for the pantorouter
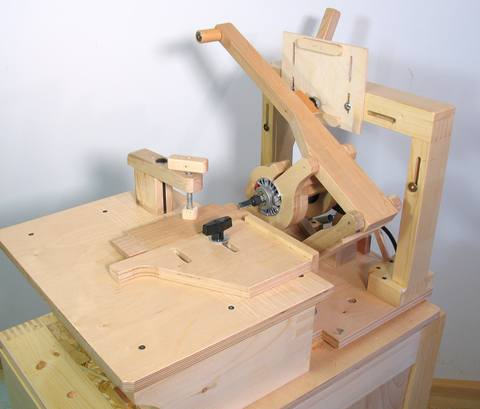
[picture p161: build/using/tenon_fence.jpg]
 People have been asking about "that piece of wood" I had clamped to the table in some of my videos about the pantorouter.
After initial design and testing of the machine, I made a sort of square to use as a fence on the pantorouter, which is now part of the plans.
The fence is a simple piece of birch plywood with two slots cut into it, and a piece of wood along one edge to align it with the table.
One slot is used for clamping the square down to use it to align the stock for making tenons.

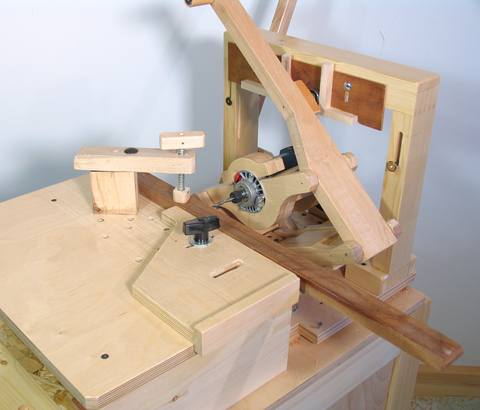
[picture p162: build/using/mortise_fence.jpg]
 The other configuration of this square is to use the other slot, and bring it in from the side to use it as a back stop when cutting mortises.
