JohnFrei/Pantorouter/build/pantograph/grace_outline-b.jpg

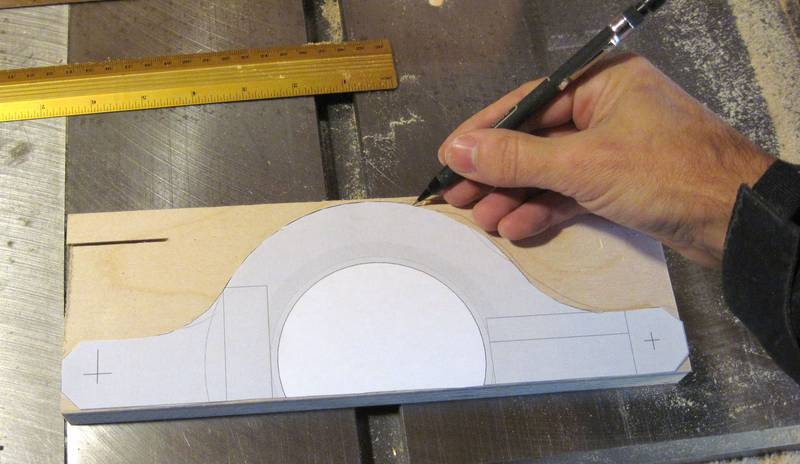
build/pantograph/grace_outline-b.jpg
